Mario4CE/Sistema-Comunicacion-Optica-CC/Prototipos/Circuito/PruebaLab1.jpeg

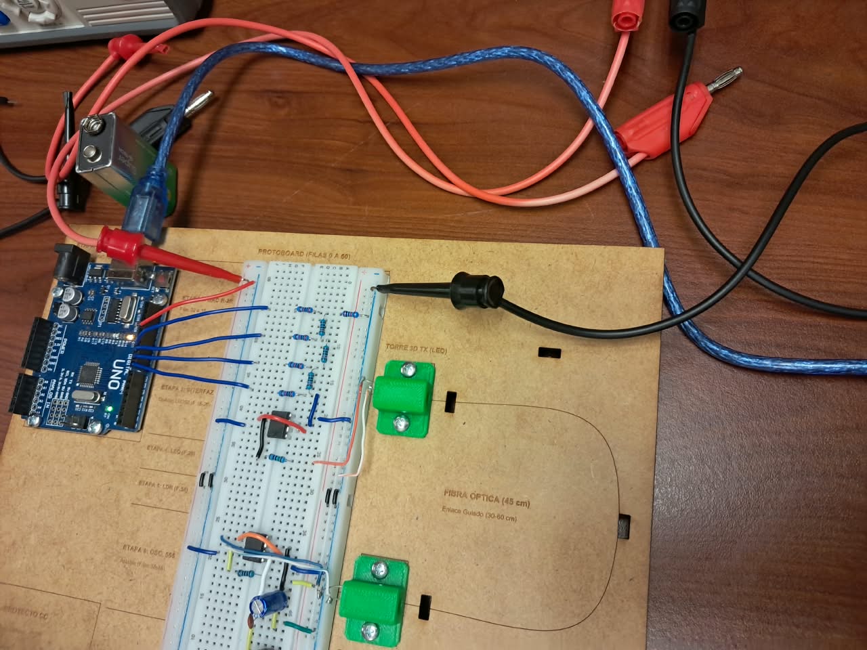
Prototipos/Circuito/PruebaLab1.jpeg
