Mario4CE/Sistema-Comunicacion-Optica-CC/Prototipos/Circuito/CircuitoArmado.jpeg

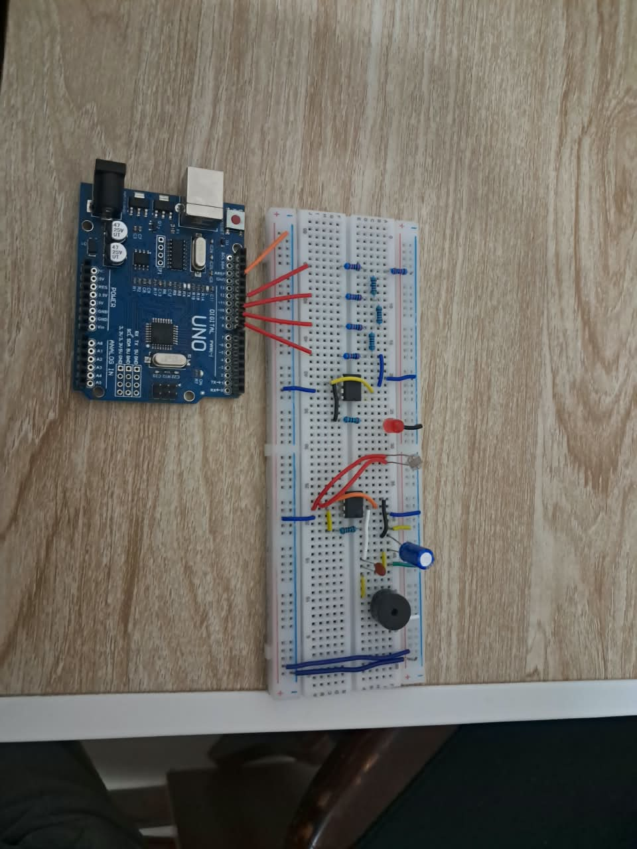
Prototipos/Circuito/CircuitoArmado.jpeg
