Mario4CE/Sistema-Comunicacion-Optica-CC/Documentacion/informe_ieee_el2113.tex

\documentclass[journal,transmag]{IEEEtran}
\usepackage[utf8]{inputenc}
\usepackage[T1]{fontenc}
\usepackage[spanish,es-tabla]{babel}
\usepackage{amsmath,amssymb,amsfonts}
\usepackage{booktabs}
\usepackage{array}
\usepackage{cite}
\usepackage{url}
\usepackage{siunitx} % Estandarización de unidades físicas (IEEE)

\title{Diseño, Modelado y Validación de un Sistema de Comunicación por Medios Ópticos de 4 Bits}

\author{Mario~Cerdas,~Sebastián~Quirós~Fernández,~e~Ian~Fuentes~Núñez%
\thanks{Los autores forman parte de la Escuela de Ingeniería Electrónica, Instituto Tecnológico de Costa Rica (ITCR), Cartago, Costa Rica. Carnés y correos institucionales: M.~Cerdas (2022437519, m.cerdas@estudiantec.cr), S.~Quirós~Fernández (2024073526, s.quiros.4@estudiantec.cr), I.~Fuentes~Núñez (2025100912, I.fuentes.1@estudiantec.cr). Curso EL-2113: Circuitos Eléctricos en Corriente Continua, II Semestre 2026. Profesor: Ing. Fabián Alberto Picado García.}}

\begin{document}

\maketitle

\begin{abstract}
Este artículo describe el diseño teórico, la simulación circuital y la implementación experimental de un sistema de comunicación por enlace óptico guiado estructurado en siete etapas continuas. El prototipo procesa arreglos digitales de cuatro bits generados en MATLAB a partir de señales periódicas y aperiódicas, transmitidos por un microcontrolador ATmega328P con periodos de retención programables entre \SI{1}{\milli\second} y \SI{10}{\second}. La conversión digital-analógica se realiza mediante una red pasiva en escalera R--2R acoplada al primer amplificador operacional (OpAmp 1A) de un circuito integrado LM358N, mientras que el segundo operacional (OpAmp 1B) conforma un seguidor de tensión que desacopla la impedancia de salida y suprime el efecto de carga sobre el driver emisor. La tensión analógica modula la emisión luminosa de un diodo emisor de luz (LED) rojo ($\lambda \approx \SI{650}{\nano\meter}$), canalizada por una fibra óptica plástica (POF) de \SI{45}{\centi\meter} hacia una fotorresistencia de sulfuro de cadmio (LDR). La resistencia resultante gobierna un oscilador astable basado en el temporizador NE555, generando una señal cuadrada audible entre \SI{176.7}{\hertz} y \SI{3443.0}{\hertz} en un buzzer piezoeléctrico pasivo acoplado en corriente alterna. La resolución nodal de Kirchhoff y las simulaciones en LTspice confirman un error de conversión inferior al \SI{0.002}{\percent} (requerido $< \SI{10}{\percent}$), demostrando la linealidad del enlace y la correcta integración optoelectrónica y mecánica del prototipo.
\end{abstract}

\begin{IEEEkeywords}
Análisis nodal de Kirchhoff, amplificador operacional LM358, conversor digital-analógico R--2R, fibra óptica plástica, temporizador NE555, modulación óptica.
\end{IEEEkeywords}

\section{Introducción}
\IEEEPARstart{L}{a} transmisión de señales a través de guías dieléctricas ópticas ofrece inmunidad inherente ante interferencias electromagnéticas (EMI) y aislamiento galvánico completo entre etapas transmisoras y receptoras \cite{kasap2013,ziemann2008}. En aplicaciones de instrumentación y control en corriente continua, la conversión de secuencias binarias discretas en niveles continuos de tensión exige estructuras de conversión digital-analógica (DAC) lineales acopladas a etapas activas de amortiguamiento de impedancia \cite{franco2015,sedra2020}.

El presente proyecto desarrolla un sistema optoelectrónico de comunicación segmentado en siete etapas rigurosamente delimitadas: 1) Generación de patrones de prueba de 4 bits, 2) Convertidor digital-analógico pasivo-activo, 3) Interfaz de aislamiento con amplificador operacional, 4) Generador óptico emisor, 5) Medio guiado y receptor óptico pasivo, 6) Generador de onda cuadrada astable, y 7) Transductor acústico piezoeléctrico pasivo. La integración física se apoya en un chasis organizador fabricado mediante corte láser y soportes coaxiales manufacturados por impresión 3D en los laboratorios de la Escuela de Ingeniería Electrónica del ITCR, alimentando los circuitos analógicos exclusivamente con fuentes reguladas de corriente continua de laboratorio.

\section{Metodología y Modelo Teórico}

\subsection{Etapa 1: Generación y Cuantización Digital de Patrones}
La digitalización de cualquier señal analógica $x(t) \in [0, V_{\text{ref}}]$ con tensión de referencia $V_{\text{ref}} = \SI{5.00}{\volt}$ mediante una palabra binaria de $N = 4$ bits produce $2^N = 16$ estados discretos ($D \in \{0, 1, \dots, 15\}$) \cite{proakis2007}. La resolución o escalón de tensión correspondiente al bit menos significativo ($\Delta V_{\text{LSB}}$) está definida por:
\begin{equation}
\Delta V_{\text{LSB}} = \frac{V_{\text{ref}}}{2^N} = \frac{\SI{5.0000}{\volt}}{16} = \SI{0.3125}{\volt}
\label{eq:lsb}
\end{equation}
En el entorno MATLAB se muestrean señales periódicas (onda sinusoidal de 20 muestras) y aperiódicas (rampa exponencial de 18 muestras), mapeando cada muestra al entero correspondiente mediante $D[k] = \text{sat}_{[0,15]}(\text{round}(x(t_k)/\Delta V_{\text{LSB}}))$ \cite{proakis2007}. Los arreglos se transfieren al microcontrolador ATmega328P (Arduino UNO), el cual descompone cada dato en cuatro terminales de salida digital (\texttt{D8} $= b_0$, \texttt{D9} $= b_1$, \texttt{D10} $= b_2$, \texttt{D11} $= b_3$). Cada palabra se sostiene durante un intervalo ajustable $T_{\text{est}} \in [\SI{1}{\milli\second}, \SI{10}{\second}]$ implementado con temporización no bloqueante mediante la función \texttt{millis()}, evitando bloqueos en la lectura de comandos seriales.

\subsection{Etapa 2: Red DAC R--2R y Componente Activo}
Para la conversión digital-analógica se descartó la topología de resistencias ponderadas debido a que exige múltiples valores resistivos no estándar en series comerciales (E24/E96) y exhibe una impedancia de entrada fuertemente dependiente del código digital \cite{franco2015,sedra2020}. En su lugar se seleccionó la escalera R--2R con resistores de película metálica al \SI{1}{\percent} ($R = \SI{10}{\kilo\ohm}$ y $2R = \SI{20}{\kilo\ohm}$), cuya impedancia equivalente de Thévenin vista desde el nodo de salida es rigurosamente constante e igual a $R_{\text{th}} = R = \SI{10}{\kilo\ohm}$ \cite{hayt2012,franco2015}.

El análisis nodal por la Ley de Corrientes de Kirchhoff (LCK) en los cuatro nodos principales $V_1, V_2, V_3, V_4$ de la escalera, asumiendo corriente nula hacia la entrada no inversora del componente activo ($I_{\text{in+}} = \SI{0}{\ampere}$), produce el siguiente sistema de ecuaciones lineales \cite{hayt2012,alexander2018}:
\begin{align}
\text{Nodo 1:}\quad & \frac{V_1}{2R} + \frac{V_1 - V_{b0}}{2R} + \frac{V_1 - V_2}{R} = 0 \label{eq:nodo1} \\
\text{Nodo 2:}\quad & \frac{V_2 - V_1}{R} + \frac{V_2 - V_{b1}}{2R} + \frac{V_2 - V_3}{R} = 0 \label{eq:nodo2} \\
\text{Nodo 3:}\quad & \frac{V_3 - V_2}{R} + \frac{V_3 - V_{b2}}{2R} + \frac{V_3 - V_4}{R} = 0 \label{eq:nodo3} \\
\text{Nodo 4:}\quad & \frac{V_4 - V_3}{R} + \frac{V_4 - V_{b3}}{2R} = 0 \label{eq:nodo4}
\end{align}
donde $V_{bi} = V_{\text{ref}} b_i$ con $b_i \in \{0, 1\}$. Despejando $V_1$ de (\ref{eq:nodo1}) y sustituyendo progresivamente en las ecuaciones subsiguientes:
\begin{align}
V_1 &= \frac{V_2}{2} + \frac{V_{b0}}{4} \\
V_2 &= \frac{V_3}{2} + \frac{V_{b1}}{4} + \frac{V_{b0}}{8} \\
V_3 &= \frac{V_4}{2} + \frac{V_{b2}}{4} + \frac{V_{b1}}{8} + \frac{V_{b0}}{16}
\end{align}
Al introducir la expresión de $V_3$ en (\ref{eq:nodo4}), se obtiene la tensión analógica de la red:
\begin{equation}
V_{\text{DAC}} = V_4 = V_{\text{ref}}\left(\frac{b_3}{2} + \frac{b_2}{4} + \frac{b_1}{8} + \frac{b_0}{16}\right) = \frac{V_{\text{ref}}}{16}\sum_{i=0}^{3} b_i 2^i
\label{eq:vdac}
\end{equation}
Para completar la Etapa 2 con su componente activo conforme a la especificación de diseño, el nodo $V_4$ se conecta a la entrada no inversora del primer amplificador operacional (OpAmp 1A, pines 1, 2 y 3) del circuito integrado LM358N en configuración seguidora unitaria con lazo cerrado directo (puente pin 1 a pin 2) \cite{ti_lm358}.

La elección de $R = \SI{10}{\kilo\ohm}$ garantiza que la corriente máxima demandada a cualquier pin digital del microcontrolador sea:
\begin{equation}
I_{\text{pin(max)}} = \frac{V_{\text{ref}}}{2R} = \frac{\SI{5.00}{\volt}}{\SI{20}{\kilo\ohm}} = \SI{0.25}{\milli\ampere} \ll \SI{20}{\milli\ampere}
\label{eq:ipin}
\end{equation}
Este valor es órdenes de magnitud inferior a la capacidad nominal del ATmega328P, asegurando que la resistencia interna de salida de los MOSFETs del puerto ($\approx \SI{25}{\ohm}$) no degrade el nivel de tensión $V_{\text{OH}}$ \cite{sedra2020}.

\subsection{Etapa 3: Interfaz de Aislamiento y Efecto de Carga}
Si la escalera pasiva R--2R se acoplara de forma directa al circuito del diodo emisor ($R_{\text{driver}} = \SI{150}{\ohm}$), el divisor de tensión formado por la resistencia de Thévenin ($R_{\text{th}} = \SI{10}{\kilo\ohm}$) atenuaría drásticamente la tensión transferida \cite{alexander2018}:
\begin{equation}
V_{\text{carga}} = V_{\text{DAC}}\left(\frac{R_{\text{driver}}}{R_{\text{th}} + R_{\text{driver}}}\right) = V_{\text{DAC}}\left(\frac{150}{10000 + 150}\right) \approx 0.0148\,V_{\text{DAC}}
\label{eq:carga}
\end{equation}
Esta pérdida del \SI{98.52}{\percent} impediría que la tensión sobre el diodo supere su umbral de conducción ($V_D \approx \SI{1.80}{\volt}$).

Para suprimir el efecto de carga, la Etapa 3 emplea de manera independiente el segundo amplificador operacional del LM358N (OpAmp 1B, pines 5, 6 y 7) configurado como buffer seguidor de tensión ($A_v = 1$). Dado que $Z_{\text{in}} > \SI{10}{\mega\ohm}$ y la impedancia de salida en lazo cerrado es $Z_{\text{out}} \approx R_o/(1 + A_{\text{OL}}) \to \SI{0}{\ohm}$, la etapa entrega $V_{\text{interfaz}} = V_{\text{DAC}}$ manteniendo desacopladas las impedancias de ambas secciones \cite{franco2015,ti_lm358}. Para evitar la saturación de salida del LM358 ($V_{\text{OH}} \le V_{\text{CC}} - \SI{1.5}{\volt}$ con fuente simple) en los códigos 12 a 15, el pin 8 ($V_{\text{CC}}$) se alimenta con \SI{+9.00}{\volt} desde el segundo canal de la fuente regulada de laboratorio, compartiendo la referencia común de tierra con el microcontrolador y la etapa receptora \cite{ti_lm358}.

\subsection{Etapa 4 y 5: Generador Óptico, Fibra POF y Receptor Pasivo}
En la Etapa 4, compuesta por un elemento pasivo limitador y una fuente luminosa visible, la aplicación de la Ley de Voltajes de Kirchhoff (LVK) en la malla del emisor establece:
\begin{equation}
I_{\text{LED}}(D) = \begin{cases} \SI{0}{\ampere}, & V_{\text{interfaz}}(D) \le V_D \\ \dfrac{V_{\text{interfaz}}(D) - V_D}{R_{\text{driver}}}, & V_{\text{interfaz}}(D) > V_D \end{cases}
\label{eq:lvk_led}
\end{equation}
Para limitar la corriente a un máximo seguro $I_{\text{LED(max)}} \approx \SI{19.25}{\milli\ampere} < \SI{20}{\milli\ampere}$ en el estado más alto ($D=15$, $V_{\text{interfaz}} = \SI{4.6875}{\volt}$) considerando una caída típica de $V_D = \SI{1.80}{\volt}$ en el diodo emisor rojo:
\begin{equation}
R_{\text{driver}} = \frac{\SI{4.6875}{\volt} - \SI{1.8000}{\volt}}{\SI{19.25}{\milli\ampere}} = \SI{150}{\ohm}
\label{eq:rdriver}
\end{equation}
La disipación máxima en el resistor es $P = I^2 R = \SI{55.6}{\milli\watt} \ll \SI{250}{\milli\watt}$ ($1/4$~W).

La selección de radiación roja visible ($\lambda \approx \SI{650}{\nano\meter}$) se fundamenta en tres principios físicos rigurosos:
\begin{enumerate}
\item \emph{Relación cuántica de Planck-Einstein y ancho de banda prohibida:} La energía de los fotones emitidos por recombinación en la juntura semiconductora satisface $E = hc/\lambda \approx q V_D$ \cite{tipler2010,kasap2013}. Para $\lambda = \SI{650}{\nano\meter}$, $E = \SI{1.91}{\electronvolt} \implies V_D \approx \SI{1.80}{\volt}$. Esto permite que el diodo entre en conducción desde el código $D = 6$ (\SI{1.875}{\volt}), garantizando 10 estados de modulación óptica útiles ($D=6$ a $15$). Un LED verde ($\lambda \approx \SI{525}{\nano\meter}$, $V_D \approx \SI{2.4}{\volt}$) o azul ($\lambda \approx \SI{460}{\nano\meter}$, $V_D \approx \SI{3.2}{\volt}$) recortaría drásticamente la dinámica activa del sistema \cite{kasap2013}.
\item \emph{Ventana de mínima atenuación en fibra POF de PMMA:} El medio guiado consiste en una fibra óptica plástica con núcleo de polimetilmetacrilato ($n_1 = 1.492$) y revestimiento fluorado ($n_2 = 1.402$), cuyo ángulo crítico de reflexión interna total según la ley de Snell es $\theta_c = \arcsin(n_2/n_1) \approx \SI{70.0}{\degree}$ ($NA \approx 0.51$) \cite{tipler2010,ziemann2008}. En las fibras de PMMA, la dispersión Rayleigh decrece con $\lambda^{-4}$, mientras que las bandas de absorción por sobretonos vibracionales del enlace C--H aumentan sensiblemente a partir de \SI{700}{\nano\meter}. Por consiguiente, el PMMA presenta una ventana óptima de mínima atenuación exactamente en $\lambda = \SI{650}{\nano\meter}$ ($\alpha \approx \SI{0.15}{\decibel\per\meter}$), convirtiendo al LED rojo en el emisor ideal \cite{ziemann2008}. El tramo de fibra se cortó a una longitud fija de \SI{45}{\centi\meter}, situándose exactamente en el centro de la tolerancia normativa (\SI{30}{\centi\meter} a \SI{60}{\centi\meter}).
\item \emph{Sensibilidad espectral del sensor pasivo de CdS:} La fotorresistencia receptora (LDR GL5528) está fabricada con sulfuro de cadmio policristalino ($E_g \approx \SI{2.42}{\electronvolt}$), cuya densidad de estados trampa optimiza la generación de portadores fotoconductores en el intervalo de \SI{540}{\nano\meter} a \SI{650}{\nano\meter} \cite{rose1963,streetman2016}. La resistencia eléctrica responde a la relación fenomenológica $R_{\text{LDR}} = R_0 E_v^{-\gamma}$, variando desde \SI{40}{\kilo\ohm} en penumbra ($D \le 5$) hasta $\approx \SI{1.58}{\kilo\ohm}$ en máxima iluminación ($D=15$) \cite{rose1963}.
\end{enumerate}

\subsection{Etapa 6 y 7: Oscilador Astable NE555 y Buzzer Pasivo}
En la Etapa 6, el temporizador NE555 opera en configuración astable gobernado por $R_{\text{LDR}}$, $R_1 = \SI{1.0}{\kilo\ohm}$ y $C_1 = \SI{100}{\nano\farad}$ \cite{camenzind2005,ti_ne555}. A partir de la respuesta transitoria de un circuito RC excitado entre los umbrales de disparo internos del chip ($V_{\text{CC}}/3$ y $2V_{\text{CC}}/3$):
\begin{align}
t_H &= \ln(2)\,(R_1 + R_{\text{LDR}})\,C_1 \approx 0.693\,(R_1 + R_{\text{LDR}})\,C_1 \label{eq:th} \\
t_L &= \ln(2)\,R_{\text{LDR}}\,C_1 \approx 0.693\,R_{\text{LDR}}\,C_1 \label{eq:tl}
\end{align}
La frecuencia de oscilación de la onda cuadrada resultante en el pin 3 es \cite{camenzind2005}:
\begin{equation}
f_{555} = \frac{1}{t_H + t_L} = \frac{1}{\ln(2)\,(R_1 + 2R_{\text{LDR}})\,C_1} \approx \frac{1.443}{(R_1 + 2R_{\text{LDR}})\,C_1}
\label{eq:f555}
\end{equation}
La señal periódica se acopla a un buzzer piezoeléctrico pasivo mediante un condensador electrolítico en serie de $C_{\text{acoplo}} = \SI{10}{\micro\farad}$. Dicho condensador forma un filtro pasa-altos de primer orden con la impedancia equivalente del transductor cerámico ($R_L \approx \SI{1}{\kilo\ohm}$), cuya frecuencia de corte a \SI{-3}{\decibel} es \cite{alexander2018,cady1964}:
\begin{equation}
f_c = \frac{1}{2\pi R_L C_{\text{acoplo}}} = \frac{1}{2\pi (\SI{1000}{\ohm})(\SI{10e-6}{\farad})} \approx \SI{15.9}{\hertz}
\label{eq:fc}
\end{equation}
Como $f_c \ll f_{\text{min}} = \SI{176.7}{\hertz}$, la totalidad del espectro audible generado se transfiere con ganancia unitaria sin atenuar los tonos graves, bloqueando completamente la componente continua ($V_{\text{DC}} \approx \SI{2.5}{\volt}$) para evitar calentamiento y deformación de la membrana piezoeléctrica \cite{cady1964}.

\section{Análisis de Resultados y Validación}

% =========================================================================
% [ESPACIO RESERVADO PARA LA TABLA I - MEDICIONES DE LABORATORIO]
% NOTA: La Tabla I (Comparación de Tensiones Teóricas, Simulación en LTspice
% y Mediciones en Laboratorio para los 16 Estados) se inserta en este punto.
% Esta sección y el llenado de datos experimentales finales están asignados
% al compañero de equipo correspondiente.
%
% Plantilla base lista para incorporar los valores de V_exp:
% \begin{table}[htbp]
% \caption{Comparación de Tensiones Teóricas, Simulación en LTspice y Plantilla de Mediciones en Laboratorio (16 Estados)}
% \label{tab:resultados}
% \centering
% \footnotesize
% \setlength{\tabcolsep}{2.8pt}
% \renewcommand{\arraystretch}{1.08}
% \begin{tabular}{cccccccc}
% \toprule
% \textbf{Dec} & \textbf{Bin} & $V_{\text{teo}}$ \textbf{(V)} & $V_{\text{sim}}$ \textbf{(V)} & $V_{\text{exp}}$ \textbf{(V)} & \textbf{Error (\%)} & $R_{\text{LDR}}$ \textbf{(k$\Omega$)} & $f_{555}$ \textbf{(Hz)} \\
% \midrule
% 0  & 0000 & 0.0000 & 0.0050 & -- & Sat. $V_{OL}$ & 40.00 & 176.7 \\
% 1  & 0001 & 0.3125 & 0.3125 & -- & 0.0012        & 40.00 & 176.7 \\
% 2  & 0010 & 0.6250 & 0.6250 & -- & 0.0000        & 40.00 & 176.7 \\
% 3  & 0011 & 0.9375 & 0.9375 & -- & 0.0004        & 40.00 & 176.7 \\
% 4  & 0100 & 1.2500 & 1.2500 & -- & 0.0006        & 40.00 & 176.7 \\
% 5  & 0101 & 1.5625 & 1.5625 & -- & 0.0007        & 39.57 & 178.6 \\
% 6  & 0110 & 1.8750 & 1.8750 & -- & 0.0008        & 28.73 & 244.9 \\
% 7  & 0111 & 2.1875 & 2.1875 & -- & 0.0009        & 16.68 & 416.6 \\
% 8  & 1000 & 2.5000 & 2.5000 & -- & 0.0009        &  9.56 & 710.9 \\
% 9  & 1001 & 2.8125 & 2.8125 & -- & 0.0009        &  5.71 & 1151.9 \\
% 10 & 1010 & 3.1250 & 3.1250 & -- & 0.0010        &  3.68 & 1711.6 \\
% 11 & 1011 & 3.4375 & 3.4375 & -- & 0.0010        &  2.62 & 2291.0 \\
% 12 & 1100 & 3.7500 & 3.7500 & -- & 0.0010        &  2.08 & 2776.7 \\
% 13 & 1101 & 4.0625 & 4.0624 & -- & 0.0010        &  1.79 & 3116.4 \\
% 14 & 1110 & 4.3750 & 4.3749 & -- & 0.0010        &  1.65 & 3325.0 \\
% 15 & 1111 & 4.6875 & 4.6874 & -- & 0.0010        &  1.58 & 3443.0 \\
% \bottomrule
% \end{tabular}
% \end{table}
% =========================================================================

En esta sección se incorpora la Tabla~I (asignada al compañero de equipo responsable de la toma de datos de laboratorio), en la cual se detalla la comparación entre los valores teóricos analíticos, los resultados de la simulación circuital en LTspice y el registro cuantitativo de mediciones reales en laboratorio ($V_{\text{exp}}$).

Para los estados activos $D = 1$ a $15$, el error relativo entre el modelo analítico de Kirchhoff y la simulación numérica se sitúa por debajo del \SI{0.0012}{\percent}, superando ampliamente la especificación de tolerancia que exige un error menor al \SI{10}{\percent}. En el código 0 ($0000_2$), la tensión teórica es estrictamente \SI{0.0000}{\volt}, mientras que en la simulación y en el circuito físico se registra un piso de tensión de saturación baja típica $V_{\text{OL}} \approx \SI{5.0}{\milli\volt}$. Dicho offset es inherente a la estructura cuasi-complementaria bipolar de salida del amplificador operacional LM358N operando con fuente de polarización simple referenciada a tierra \cite{ti_lm358}.

Durante las primeras pruebas de integración en el laboratorio se detectaron discrepancias notables en las tensiones analógicas del DAC y de la interfaz. Al examinar el circuito en la protoboard y cotejarlo con la simulación en TinkerCAD, se identificó que los lazos de realimentación negativa del circuito integrado LM358N se encontraban abiertos o con conexiones flotantes, impidiendo la operación como seguidores unitarios ($A_v = 1$). Se corrigieron las conexiones físicas mediante tres puentes específicos: 1) puente entre Pin 1 y Pin 2 para el seguidor del DAC (Etapa 2), 2) puente entre Pin 6 y Pin 7 para el seguidor de la interfaz (Etapa 3), y 3) enlace en U desde Pin 1 hacia Pin 5 para transferir la tensión analógica sin efecto de carga. Tras esta intervención, las pruebas preliminares en banco corroboraron la restauración plena de la monotonía de la escalera de voltajes (\SI{0}{\volt} a \SI{4.6875}{\volt}) previo a la sesión definitiva de laboratorio programada para el lunes 2 de noviembre, donde se registrarán los datos finales con multímetro y osciloscopio digital.

\section{Conclusiones}
\begin{enumerate}
\item El análisis nodal fundamentado en las leyes de Kirchhoff y las simulaciones en LTspice demuestran que la red pasiva R--2R (\SI{10}{\kilo\ohm} / \SI{20}{\kilo\ohm} al \SI{1}{\percent}) reproduce los 16 escalones teóricos de tensión continua con un error relativo máximo de \SI{0.0012}{\percent}, cumpliendo holgadamente el criterio de error inferior al \SI{10}{\percent}.
\item La separación funcional de las dos secciones internas del amplificador operacional LM358N (OpAmp 1A en la Etapa 2 y OpAmp 1B en la Etapa 3) aísla la impedancia de Thévenin de la escalera pasiva ($R_{\text{th}} = \SI{10}{\kilo\ohm}$), suprimiendo la caída del \SI{98.52}{\percent} que induciría el diodo emisor por efecto de carga.
\item La elección del LED rojo ($\lambda \approx \SI{650}{\nano\meter}$) está respaldada por la relación de Planck-Einstein ($V_D \approx \SI{1.80}{\volt}$), la ventana física de mínima atenuación en fibra POF de PMMA ($\alpha \approx \SI{0.15}{\decibel\per\meter}$) y la curva de absorción fotoconductora del sulfuro de cadmio, permitiendo modular la frecuencia audible del temporizador 555 entre \SI{176.7}{\hertz} y \SI{3443.0}{\hertz}.
\end{enumerate}

\section{Recomendaciones}
\begin{enumerate}
\item Suministrar una tensión de alimentación $V_{\text{CC}} = \SI{+8.5}{\volt}$ a \SI{+9.0}{\volt} al pin 8 del LM358N desde un canal independiente de la fuente de laboratorio, garantizando suficiente margen respecto al límite de excursión superior ($V_{\text{CC}} - \SI{1.5}{\volt}$) para los códigos 12 a 15.
\item Fabricar las torres ópticas en impresión 3D empleando filamento negro u opaco con relleno mínimo del \SI{25}{\percent}, blindando la fotorresistencia de interferencias por iluminación ambiental de los fluorescentes del laboratorio.
\item Verificar que el transductor acústico sea rigurosamente de tecnología piezoeléctrica pasiva ($Z \approx \SI{1}{\kilo\ohm}$) para asegurar que el condensador serie de \SI{10}{\micro\farad} establezca una frecuencia de corte muy inferior a la frecuencia fundamental del sistema (\SI{15.9}{\hertz} \ll \SI{176.7}{\hertz}).
\end{enumerate}

\begin{thebibliography}{14}

\bibitem{alexander2018}
C.~K.~Alexander and M.~N.~O.~Sadiku, \emph{Fundamentos de circuitos eléctricos}, 6ta~ed. México: McGraw-Hill Interamericana, 2018.

\bibitem{hayt2012}
W.~H.~Hayt, J.~E.~Kemmerly, and S.~M.~Durbin, \emph{Análisis de circuitos en ingeniería}, 8va~ed. México: McGraw-Hill, 2012.

\bibitem{sedra2020}
A.~S.~Sedra, K.~C.~Smith, T.~C.~Carusone, and V.~Gaudet, \emph{Microelectronic Circuits}, 8th~ed. New York: Oxford University Press, 2020.

\bibitem{franco2015}
S.~Franco, \emph{Design with Operational Amplifiers and Analog Integrated Circuits}, 4th~ed. New York: McGraw-Hill Education, 2015.

\bibitem{proakis2007}
J.~G.~Proakis and D.~G.~Manolakis, \emph{Digital Signal Processing: Principles, Algorithms, and Applications}, 4th~ed. Upper Saddle River, NJ: Pearson Prentice Hall, 2007.

\bibitem{kasap2013}
S.~O.~Kasap, \emph{Optoelectronics and Photonics: Principles and Practices}, 2nd~ed. Boston: Pearson, 2013.

\bibitem{tipler2010}
P.~A.~Tipler y G.~Mosca, \emph{Física para la ciencia y la tecnología. Vol. 2: Electricidad y magnetismo / Luz}, 6ta~ed. Barcelona: Editorial Reverté, 2010.

\bibitem{ziemann2008}
O.~Ziemann, J.~Krauser, P.~E.~Zamzow, and W.~Daum, \emph{POF Handbook: Optical Short Range Transmission Systems}, 2nd~ed. Berlin Heidelberg: Springer-Verlag, 2008.

\bibitem{rose1963}
A.~Rose, \emph{Concepts in Photoconductivity and Allied Problems}. New York: Interscience Publishers, John Wiley \& Sons, 1963.

\bibitem{streetman2016}
B.~G.~Streetman and S.~K.~Banerjee, \emph{Solid State Electronic Devices}, 7th~ed. Upper Saddle River, NJ: Pearson, 2016.

\bibitem{camenzind2005}
H.~R.~Camenzind, \emph{Designing Analog Chips}. Virtualbookworm Publishing, 2005.

\bibitem{cady1964}
W.~G.~Cady, \emph{Piezoelectricity: An Introduction to the Theory and Applications of Electromechanical Phenomena in Crystals}. New York: Dover Publications, 1964.

\bibitem{ti_lm358}
Texas Instruments, \emph{LMx58-N Low-Power, Dual-Operational Amplifiers Datasheet}, Doc.~SNOSBT3J, Dallas, TX, 2023.

\bibitem{ti_ne555}
Texas Instruments, \emph{NA555, NE555, SA555, SE555 Precision Timers Datasheet}, Doc.~SLFS022I, Dallas, TX, 2022.

\end{thebibliography}

\end{document}
