Mario4CE/Sistema-Comunicacion-Optica-CC/Prototipos/Corte_laser/base_soporte_optico.pdf

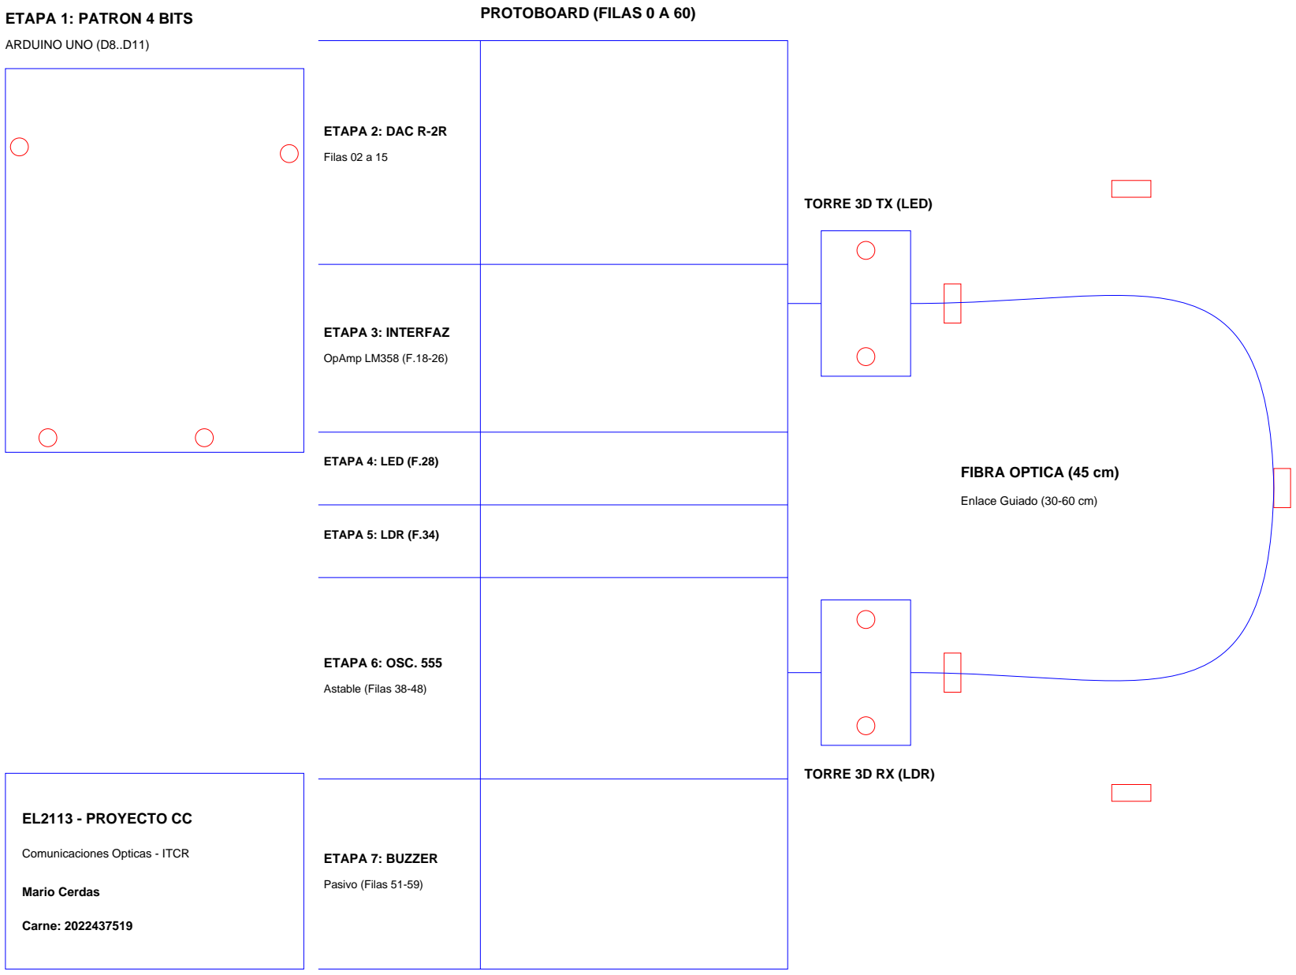
[picture p3: figure]
ETAPA 1: PATRON 4 BITS; ARDUINO UNO (D8..D11); PROTOBOARD (FILAS 0 A 60); ETAPA 2: DAC R-2R; Filas 02 a 15; ETAPA 3: INTERFAZ; OpAmp LM358 (F.18-26); ETAPA 4: LED (F.28); ETAPA 5: LDR (F.34); ETAPA 6: OSC. 555; Astable (Filas 38-48); ETAPA 7: BUZZER; Pasivo (Filas 51-59); TORRE 3D TX (LED); TORRE 3D RX (LDR); FIBRA OPTICA (45 cm); Enlace Guiado (30-60 cm); EL2113 - PROYECTO CC; Comunicaciones Opticas - ITCR; Mario Cerdas; Carne: 2022437519
