Mario4CE/Sistema-Comunicacion-Optica-CC/Prototipos/Circuito/Circuito Completo.jpeg

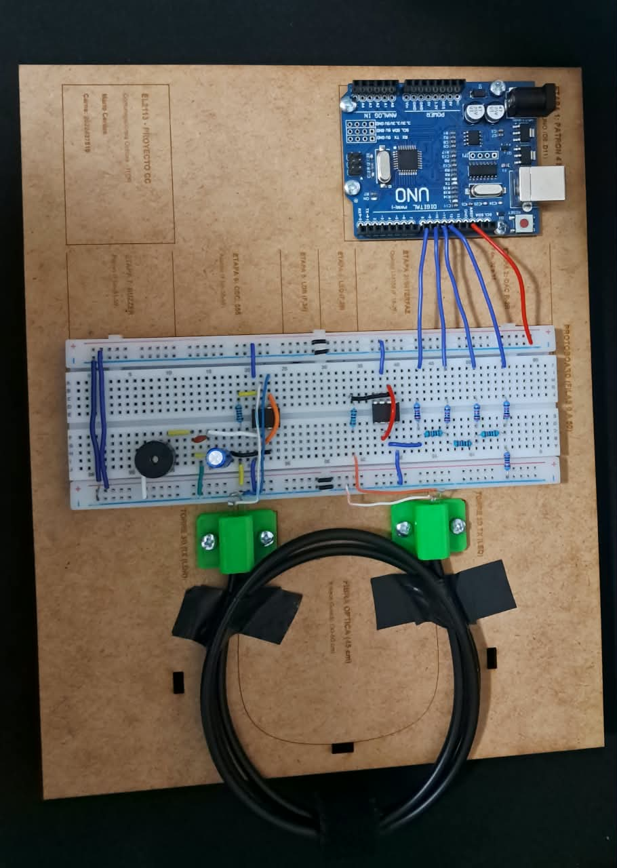
Prototipos/Circuito/Circuito Completo.jpeg
