Mario4CE/Sistema-Comunicacion-Optica-CC/Prototipos/Circuito/CircuitoC.jpeg

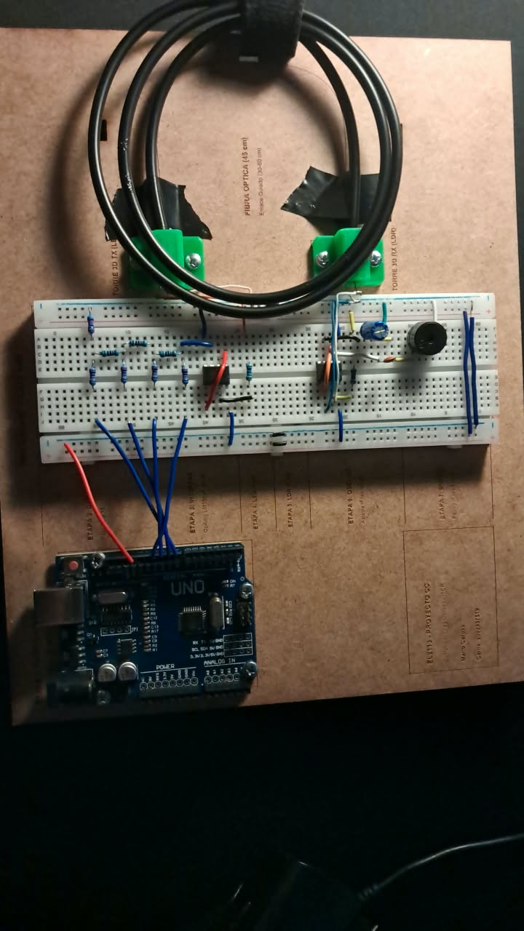
Prototipos/Circuito/CircuitoC.jpeg
