Mario4CE/Sistema-Comunicacion-Optica-CC/Prototipos/Circuito/CircuitoConBase.jpeg

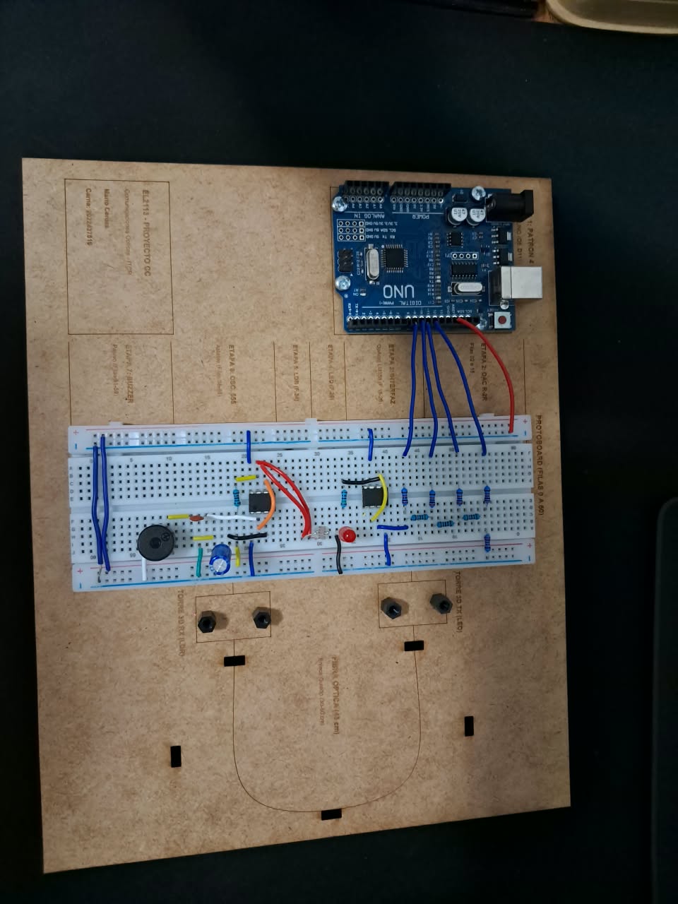
Prototipos/Circuito/CircuitoConBase.jpeg
