Mario4CE/Sistema-Comunicacion-Optica-CC/Prototipos/Circuito/Laboratorio1.jpeg

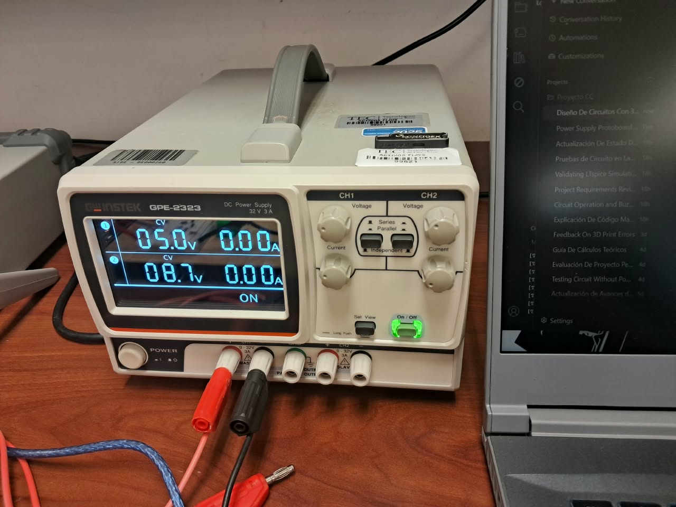
Prototipos/Circuito/Laboratorio1.jpeg
