Mario4CE/Sistema-Comunicacion-Optica-CC/Prototipos/Circuito/Laboratorio2.jpeg

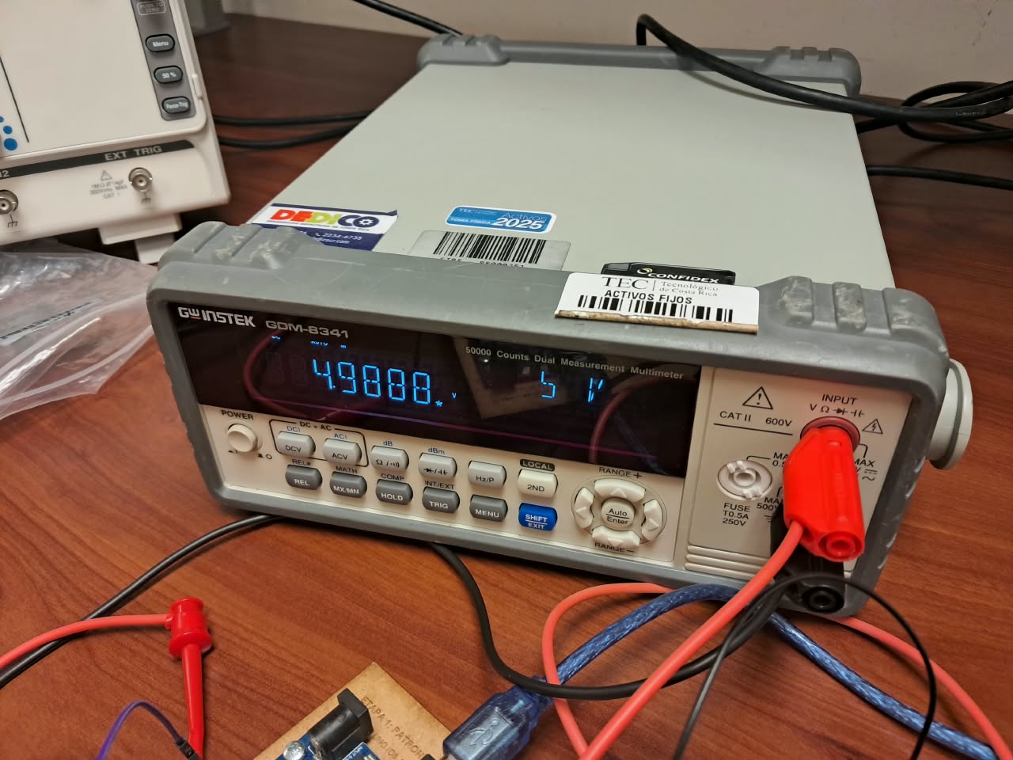
Prototipos/Circuito/Laboratorio2.jpeg
