Mario4CE/Sistema-Comunicacion-Optica-CC/Prototipos/Circuito/Laboratorio3.jpeg

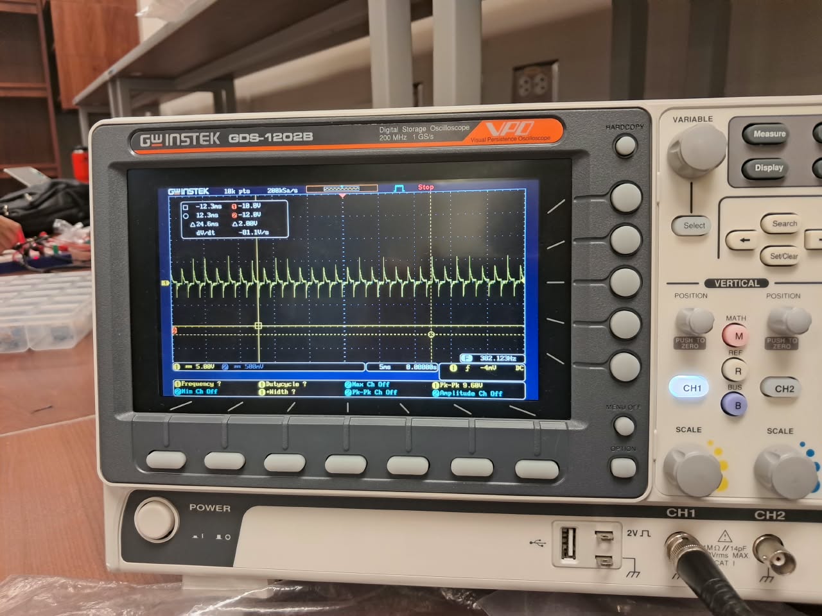
Prototipos/Circuito/Laboratorio3.jpeg
