Mario4CE/Sistema-Comunicacion-Optica-CC/TinkerCAD/Circuito.png

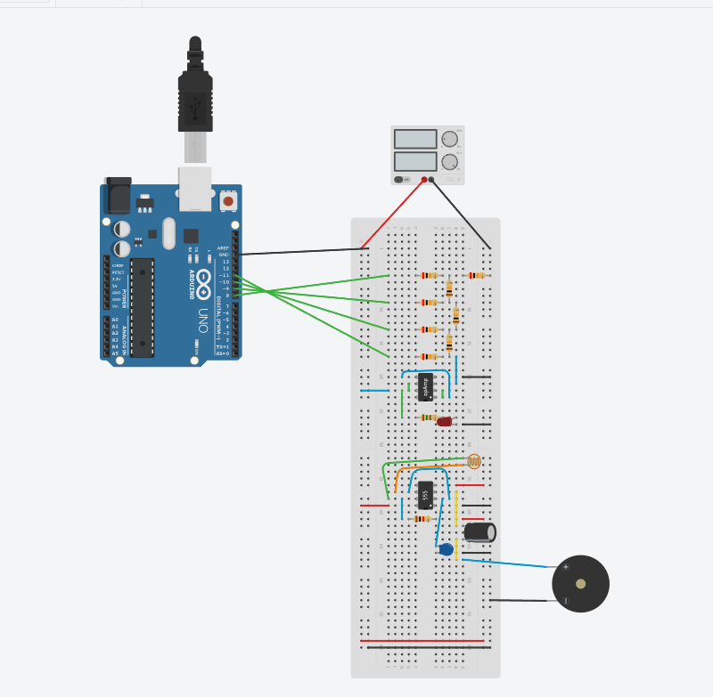
TinkerCAD/Circuito.png
