Mario4CE/Sistema-Comunicacion-Optica-CC/TinkerCAD/Esquema.png

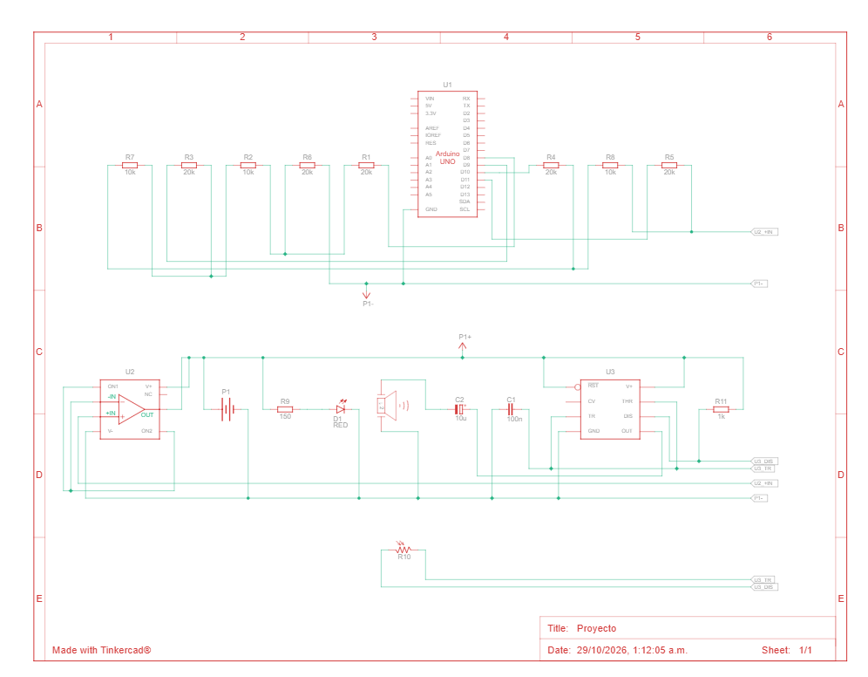
TinkerCAD/Esquema.png
