Mario4CE/Sistema-Comunicacion-Optica-CC/TinkerCAD/Componentes.png

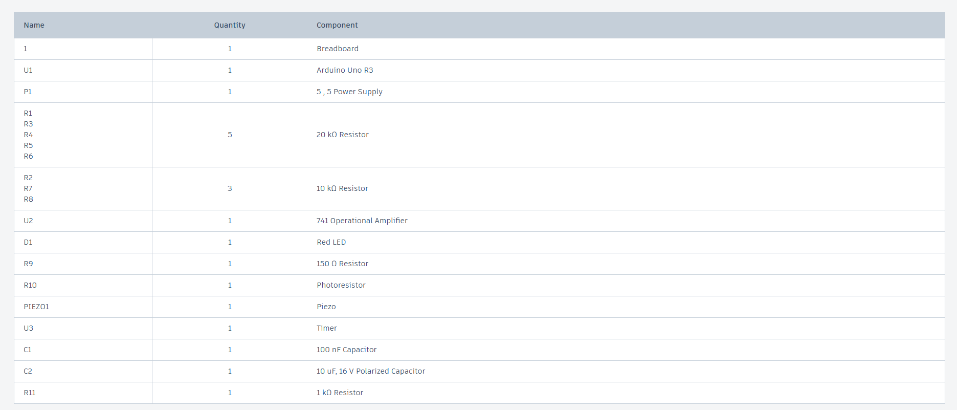
TinkerCAD/Componentes.png
