Mario4CE/Sistema-Comunicacion-Optica-CC/Prototipos/Impresion_3D/2022437519-01.stl

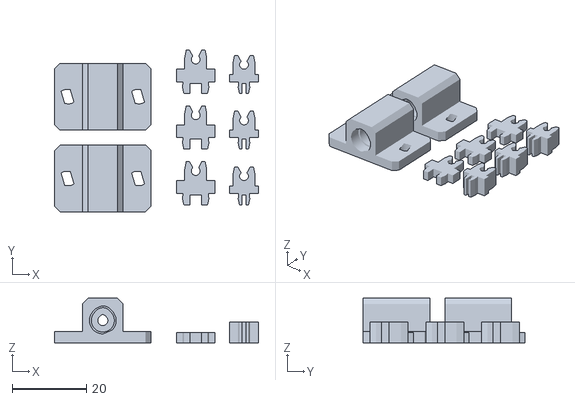
[picture p13: CAD file, 2026-10-28]
Prototipos/Impresion_3D/2022437519-01.stl
54.9 x 43.5 x 12.0
