Mario4CE/Sistema-Comunicacion-Optica-CC/Prototipos/Circuito/PruebaLab2.jpeg

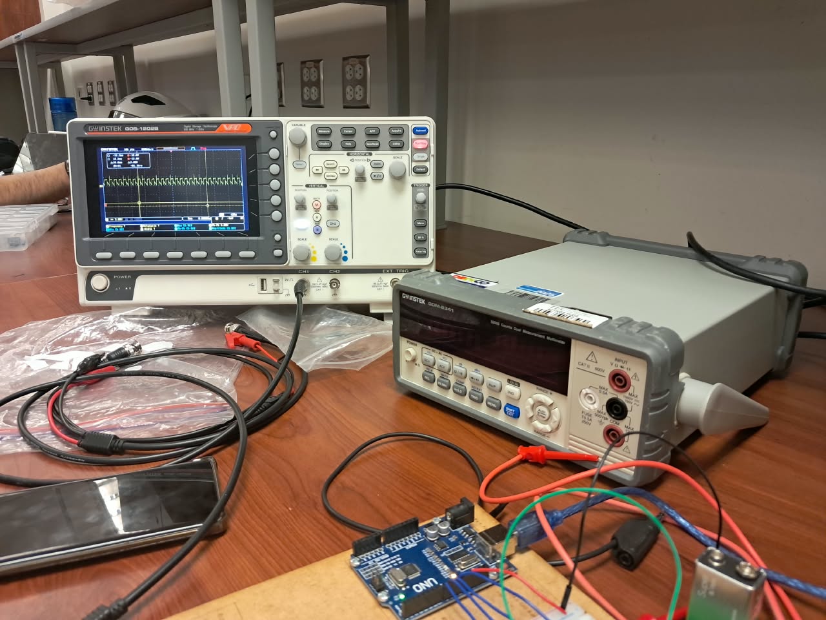
Prototipos/Circuito/PruebaLab2.jpeg
