Mario4CE/Sistema-Comunicacion-Optica-CC/LTspice/sistema_completo_optico.asc

B_LDR: bi; I=V(DIS,THR)/V(RLDR)
B_RLDR: bv; V=1500+38500*exp(-max(I(D_LED),0)/0.003)
C1: cap; 100n
C2: cap; 10n
C_acoplo: cap; 10u
D_LED: LED; D_RED_650
R1: res; 1k
R_b0: res; 20k
R_b1: res; 20k
R_b2: res; 20k
R_b3: res; 20k
R_buzzer: res; 1k
R_driver: res; 150
R_h1: res; 10k
R_h2: res; 10k
R_h3: res; 10k
R_term: res; 20k
U1A: opamp2; LM358_SIMPLE
U1B: opamp2; LM358_SIMPLE
U2: NE555
V_B0: voltage; PULSE(0 5 {T} 10n 10n {T} {2*T})
V_B1: voltage; PULSE(0 5 {2*T} 10n 10n {2*T} {4*T})
V_B2: voltage; PULSE(0 5 {4*T} 10n 10n {4*T} {8*T})
V_B3: voltage; PULSE(0 5 {8*T} 10n 10n {8*T} {16*T})
V_CC: voltage; 5
V_OP: voltage; {VOP}
Named nets: B0, B1, B2, B3, 0, V_R2R, VOP, V_DAC, V_INTERFAZ, VCC, THR, OUT_555, DIS, V_BUZZER, RLDR
SISTEMA COMPLETO DE COMUNICACION POR MEDIOS OPTICOS - 7 ETAPAS (EL2113)
Etapa 1: V_B0..V_B3 = pines D8..D11 del Arduino (escalera 0..15, cada codigo dura T)
Etapa 2: DAC R-2R + OpAmp 1A (LM358)
Etapa 3: Interfaz OpAmp 1B (LM358)
Etapa 4: R 150 + LED rojo 650 nm
Enlace optico (fibra POF 45 cm): luz modelada con I(D_LED)
Etapa 5: LDR = B_LDR (resistencia controlada por I(D_LED))
V(RLDR) = valor de la LDR en ohm: 40 k (oscuro) a ~1.6 k (LED a 19 mA)
Etapa 6: NE555 astable
Etapa 7: C_acoplo + buzzer pasivo (R_buzzer)
.param T=20m VOP=9
.tran 0 {16*T} 0 5u startup
.lib LM358_simple.lib
.model D_RED_650 D(Is=1e-19 N=1.8 Rs=2 Cjo=20p Iave=30m Vpk=5 type=LED)
.include mediciones_sistema.inc
Verificacion: View > SPICE Error Log. Para cada codigo kk: VINTkk = kk*0.3125 V, ILEDkk sube desde el codigo 6, RLDRkk baja y Fkk sube (178 Hz -> ~2.9 kHz).
Graficar V(V_INTERFAZ), I(D_LED), V(RLDR) y V(OUT_555): la onda cuadrada debe acelerarse a medida que sube la escalera.
