Mario4CE/Sistema-Comunicacion-Optica-CC/LTspice/receptor_555_ldr.asc

C1: cap; 100n
C2: cap; 10n
C_acoplo: polcap; 10u
R1: res; 1k
R_buzzer: res; 1k
R_LDR: res; {RLDR}
U2: NE555
V_CC: voltage; 5
Named nets: VCC, 0, THR, OUT_555, DIS, V_BUZZER
ETAPAS 5 A 7: Receptor LDR + Astable NE555 + Buzzer pasivo (acople AC)
Etapa 5: LDR (R_LDR, se barre con .step)
Etapa 6: NE555 astable
Etapa 7: C_acoplo + buzzer
(R_buzzer = modelo simple del piezo)
.param RLDR=10k
.step param RLDR list 1.5k 5k 10k 20k 40k
.tran 0 40m 0 2u startup
.include mediciones_555.inc
Verificacion: View > SPICE Error Log muestra, para cada valor de R_LDR, FREQ (simulada), F_TEO = 1.443/((R1+2*R_LDR)*C1) y ERR_F en %.
Graficar V(OUT_555), V(THR) (debe oscilar entre 1.67 V y 3.33 V) y V(V_BUZZER) (onda sin componente DC).
