Mario4CE/Sistema-Comunicacion-Optica-CC/LTspice/dac_r2r_buffer.asc

D_LED: LED; D_RED_650
R_b0: res; 20k
R_b1: res; 20k
R_b2: res; 20k
R_b3: res; 20k
R_driver: res; 150
R_h1: res; 10k
R_h2: res; 10k
R_h3: res; 10k
R_term: res; 20k
U1A: opamp2; LM358_SIMPLE
U1B: opamp2; LM358_SIMPLE
V_B0: voltage; PULSE(0 5 {T} 10n 10n {T} {2*T})
V_B1: voltage; PULSE(0 5 {2*T} 10n 10n {2*T} {4*T})
V_B2: voltage; PULSE(0 5 {4*T} 10n 10n {4*T} {8*T})
V_B3: voltage; PULSE(0 5 {8*T} 10n 10n {8*T} {16*T})
V_OP: voltage; {VOP}
Named nets: B0, B1, B2, B3, 0, V_R2R, VOP, V_DAC, V_INTERFAZ
ETAPAS 1 A 4: Patron de 4 bits + DAC R-2R (LM358 1A) + Interfaz (LM358 1B) + LED rojo
Etapa 1: V_B0..V_B3 = pines D8..D11 del Arduino (escalera 0..15, cada codigo dura T)
Etapa 2: DAC R-2R + OpAmp 1A (LM358)
Etapa 3: Interfaz OpAmp 1B (LM358)
Etapa 4: R 150 + LED rojo 650 nm
.param T=1m VOP=9
.tran 0 {16*T} 0 1u
.lib LM358_simple.lib
.model D_RED_650 D(Is=1e-19 N=1.8 Rs=2 Cjo=20p Iave=30m Vpk=5 type=LED)
.include mediciones_dac.inc
Verificacion: correr y abrir View > SPICE Error Log. V00..V15 deben ser k*0.3125 V (E01..E15 = error en %, debe ser < 10 %).
Graficar V(V_R2R), V(V_DAC), V(V_INTERFAZ) e I(D_LED). Cambiar VOP=5 para ver el recorte del LM358 en ~3.5 V.
