Mario4CE/Sistema-Comunicacion-Optica-CC/(commit log)

2026-10-02 Inicializar estructura de proyecto, codigo Arduino, simulacion MATLAB y documentacion de calculo
2026-10-02 Agregar simulacion SPICE, guia detallada de conexion en protoboard y actualizar bitacora
2026-10-03 feat(simulation): agregar esquematico grafico .asc de LTspice para DAC R-2R y buffer
2026-10-03 feat(simulation): agregar codigo y guia de montaje paso a paso para TinkerCAD
2026-10-03 feat(matlab): agregar generador de patrones de prueba y cuantizacion con exportacion a C++
2026-10-03 docs: actualizar bitacora con avances de LTspice, TinkerCAD y MATLAB
2026-10-03 docs: agregar guia maestra paso a paso e imagen de referencia para TinkerCAD
2026-10-09 feat(simulation): agregar simulacion de etapa receptora 555 astable modulado por LDR en LTspice
2026-10-11 feat(test): agregar suite de validacion automatica de C++ y circuitos y mejorar parser serial
2026-10-11 docs(code): estandarizar comentarios de clases y funciones con descripcion, entrada, salida y restricciones
2026-10-11 feat(compliance): cumplir al 100% requerimientos A.1-Q.18, arreglos MATLAB, laboratorios 3D/laser e informe IEEE
    [acoplador_optico_led_ldr.scad]
2026-10-12 docs: actualizar guias operativas .md para montaje fisico y generar malla STL de acopladores
    [acoplador_optico_led_ldr.stl]
2026-10-13 docs(diagrams): agregar imagen corregida de TinkerCAD y plano exacto SVG de protoboard
2026-10-13 docs(tinkercad): copiar imagenes de referencia tambien dentro de simulation/tinkercad
2026-10-13 Actualiza codigo de TinkerCAD y renombra a generador_patrones_tinkercad.ino
2026-10-13 Simulacion de Tinkercad funcional
2026-10-13 Cambios en la carpeta simulacion
2026-10-13 Limpieza de archivos repetidos y actualizacion de bitacora
2026-10-15 Corregir esquematicos de LTspice, modelo de LM358 y agregar mediciones automaticas
2026-10-15 Aclarar alimentacion de 9V para LM358 e impedancia del buzzer en las guias de montaje
2026-10-15 Actualizar informe IEEE y memoria de calculo con los resultados reales de LTspice
2026-10-15 Actualizar descripciones y comentarios en scripts de MATLAB para mayor claridad y consistencia
2026-10-16 docs(bitacora): actualizar registro de 25 commits, trazabilidad A.1-Q.18 y compra de componentes fisicos
2026-10-18 fix(ltspice): mejorar legibilidad, orientacion de textos y espaciado en esquematicos del DAC y receptor
2026-10-18 fix(ltspice): redisenar distribucion espacial del sistema completo optico de 7 etapas
2026-10-18 docs(ltspice): actualizar guia de verificacion con comandos de ejecucion batch y directrices de layout
2026-10-18 docs(bitacora): registrar optimizacion visual de esquematicos LTspice y sincronizar estado del proyecto
2026-10-21 Algunos cambios en la bitacora. Y evidencia del ensablaje del circuito en fisico
    [acoplador_optico_led_ldr.scad]
2026-10-22 feat(corte-laser): optimizar base a fraccion 1/8 de lamina LAIMI (250x200 mm) y ajustar capas RGB (0.025 mm)
2026-10-22 feat(corte-laser): generar archivo vectorial PDF en modo RGB para Trotec Speedy 360 en LAIMI (2022437519)
2026-10-22 feat(impresion-3d): adecuar torre acopladora M3 a normativa Prusa MK4 LAIMI y generar 2022437519-01.stl
    [2022437519-01.stl, acoplador_optico_led_ldr.scad]
2026-10-22 feat(impresion-3d): disenar y exportar capuchon optico directo para protoboard 2022437519-02.stl (Opcion B)
    [2022437519-02.stl, capuchon_protoboard_led_ldr.scad]
2026-10-22 assets(prototipo): agregar render 3D fotorrealista de la maqueta fisica completa ensamblada
2026-10-22 assets(prototipo): agregar ilustracion tecnica comparativa de montaje optoelectronico (Opcion A vs Opcion B)
2026-10-22 docs(protoboard): mapear tabla maestra de coordenadas exactas para protoboard grande (filas 0-60, columnas a-j)
2026-10-22 docs(laimi): actualizar guia de prototipado con reglamento LAIMI F4-05, tornilleria M3 y guion de solicitud (2022437519)
2026-10-22 docs(bom): detallar tornilleria M3x10mm, jumpers Hembra-Macho y tarifas de manufactura LAIMI
2026-10-22 docs(readme): indexar archivos oficiales LAIMI (PDF y STL con carne 2022437519) y renders 3D
2026-10-22 docs(bitacora): registrar sesion 10 de adecuacion LAIMI (PDF RGB, STL 2022437519), matriz 0-60 y 12 nuevos commits
2026-10-22 fix(corte-laser): limpiar cajetin de identificacion y reubicar rotulos de etapas fuera de la huella del protoboard
2026-10-22 feat(impresion-3d): agregar visor 3D interactivo en HTML5 para inspeccionar piezas STL 2022437519-01 y -02 sin software externo
2026-10-24 docs(bitacora): registrar sesion 11 de compra de tornillos M3, recepcion de corte laser LAIMI y ensamble del circuito en la base
2026-10-24 docs(bitacora): sincronizar hash dc0a80a de la sesion 11
2026-10-24 Se eliminan documentos basura. Se añade foto de evidencia del circuito con la base.
    [Atornillada.scad, En_proto.scad, acoplador_optico_led_ldr.stl]
2026-10-24 Cambios en la Bitacora
2026-10-28 Arreglos a documentos para lo de 3D. Ademas se adjunta evidencia del armado de circuito
    [2022437519-01.stl, 2022437519-02.stl, Atornillada.scad, En_proto.scad]
2026-10-28 Ordenamineto de carpetas conforme a lo solicitado el el enunciado del proyecto
    [2022437519-01.stl, Atornillada.scad]
2026-10-28 Actualizacion del archivo de arduino
2026-10-28 Ajustes en los codigos de arduino y matlab
2026-10-29 Pruebas en laboratorio y ajustes al circuito
2026-10-29 Evidencia de trabajo y eliminacion de archivos basura
2026-10-29 Fix de codificación en receptor_555_ldr.asc para apertura en LTspice
2026-10-29 Depuración de temporales y actualización de exclusiones para LTspice
2026-10-29 Actualización de VERIFICACION.md con resultados de simulación completos
2026-10-29 Sincronización de memoria de cálculo con resultados finales de LTspice
2026-10-29 Actualización de estado de simulaciones en README
2026-10-29 Registro en bitácora de la sesión 15 y trazabilidad de commits
2026-10-29 Actualización de encabezados de autoría y correo institucional en Arduino y MATLAB
2026-10-29 Incorporación de respaldo bibliográfico canónico en memoria de cálculo y protocolo de pruebas
2026-10-29 Registro en bitácora de la sesión 16 y actualización del correo de contacto en README
2026-11-07 docs(memoria): incorporar memoria de calculo en latex y sincronizar modelo teorico
2026-11-07 docs(bitacora): registrar sesion 17 de auditoria y actualizar indice de repositorio
2026-11-07 docs(bitacora): sincronizar hash de trazabilidad para la sesion 17
2026-11-07 docs(informe): reservar espacio para tabla I de mediciones experimentales
2026-11-07 docs(memoria): incorporar calculos complementarios de tolerancias potencia enlace y dinamica
2026-11-07 Actualizacion del documento de la documentacion final del proyecto
2026-11-07 Se elimana Documento usado en el laboratorio, ya que solo consta de las pruebas que se van a hacer y estas iran en el documento final.
2026-11-07 Se ajsuta El documento con todos los calculos hecgos. Cabe resaltar que algunos no se usaron explicitamente pero se debe de saber de donde sale o el porque de algunos acontecimientos.
2026-11-07 Se eliminan enunciados ya que no son necesarios en e repositorio
